Korb-Modular/01_PUSHER/04_Docs/BOM_Pusher_08112016_ver03.xls

Pusher_08112016_ver03.brd
Qty | Value | Device | Package | Parts | Description | MOUSER
Resistors
7 | 51 | R-EU_R0603 | R0603 | R56, R57, R58, R59, R60, R61, R63 | RESISTOR, European symbol | 667-ERJ-3GEYJ510V
5 | 270 | R-EU_R0603 | R0603 | R27, R34, R37, R39, R55 | RESISTOR, European symbol | 667-ERJ-3EKF2700V
4 | 1k | R-EU_R0603 | R0603 | R8, R14, R17, R24 | RESISTOR, European symbol | 667-ERJ-3EKF1001V
1 | 2K | R-EU_R0603 | R0603 | R54 | RESISTOR, European symbol | 667-ERJ-3EKF2001V
1 | 3,3K | R-EU_R0603 | R0603 | R52 | RESISTOR, European symbol | 667-ERJ-3EKF3301V
5 | 10k | R-EU_R0603 | R0603 | R48, R49, R50, R51,R53 | RESISTOR, European symbol | 667-ERJ-3EKF1002V
25 | 100k | R-EU_R0603 | R0603 | R1, R3, R4, R5, R6, R7, R9, R11, R13, R15, R16, R18, R19, R21, R23, R25, R26, R28, R29, R31, R33, R35, R36, R38 | RESISTOR, European symbol | 667-ERJ-3EKF1003V
7 | 470k | R-EU_R0603 | R0603 | R2, R10, R12, R20, R22, R30, R32 | RESISTOR, European symbol | 667-ERJ-3EKF4703V
8 | 10kb | POT | ALPS_POT | R40, R41, R42, R43, R44, R45, R46, R47 |  | 688-RK09L1140A66 REMARK: please check your front panels first or be ready to drill their holes bigger The diameter of he mouser pot is bigger then the panel holes
4 | FSR |  |  | X1, X2, X3, X4 | Force Sensitive Resistor 0.5" | Sparkfun: https://www.sparkfun.com/products/9375
Capacitors
8 | 100n | C-USC0603 | C0603 | C1, C2, C3, C12, C13, C14, C15, C17 | CAPACITOR, American symbol | 81-GRM188R71E104JA1J
6 | 1u | C-USC0603 | C0603 | C4, C5, C6, C7, C8, C9 | CAPACITOR, American symbol | 81-GRM18R61A105KA61J
2 | 10u | CPOL-USA | PANASONIC_A | C10, C11 | POLARIZED CAPACITOR, American symbol | 647-UWX1C100MCL2
2 | 22u | CPOL-USC | PANASONIC_C | C16, C19 | POLARIZED CAPACITOR, American symbol | 667-EEE-FP1E220AR
2 | 1N5819HW | DIODE-SOD123 | SOD123 | D1, D2 | DIODE | 621-1N5819HW-F
Semiconductors
1 | 2N3904 | MMBT3904LT1-NPN-SOT23-BEC | SOT23-BEC | T1 | NPN Transistror | 512-MMBT3904
1 | 4051D | 4051D | SO16 | IC9 | 8-channel ANALOG MULTIPLEXER | 771-HEF4051BTD-T
1 | 74HC595D | 74HC595D | SO16 | IC5 | 8-bit SHIFT REGISTER, output latch | 595-CD74HC595M
1 | 7806T | 7806T | TO220H | IC10 | Positive VOLTAGE REGULATOR | 755-BA17806T
1 | LM1117-5.0 | REG1117 | SOT223 | IC11 | 800mA and 1A Low Dropout (LDO) Positive Regulator | 926-LM1117MPX5.0NOPB
3 | MCP4822-E/SN | MCP4822-E/SN | SO08 | IC6, IC7, IC8 | Microchip MCP4822 | 579-MCP4822-E/SN
1 | TL072D | TL072D | SO08 | IC4 | OP AMP | 511-TL072CDT
3 | TL074D | TL074D | SO14 | IC1, IC2, IC3 | OP AMP | 511-TL074IYDT
Misc
2 | PTCSMD | PTCSMD | PTC-1206 | P1, P2 | Resettable Fuse PTC | 504-PTS120616V025
5 |  | LED3MM | LED3MM | LED1, LED2, LED3, LED4, LED5 | LED | 604-WP424GDT
1 | PCB ver03.brd |  |  |  |  | www.Korb-Modular.com
1 | Panel |  |  |  |  | www.Korb-Modular.com
Mechanical
1 | M05X2PTH | M05X2PTH | AVR_ICSP | JP2 | Header 5x2 | 5X2 Power Connector
2 | Arduino Socket |  |  |  | Header 15x1 | 855-M20-7821546
12 | Jack | WQP-PJ301M-12_JACK | WQP-PJ301M-12_JACK | J1, J2,J3,J4,J5,J6,J7,J8,J9,J10,J11,J12 |  | e.g Thonk
Controller
1 | NANO | NANO | NANO | U$1 | Arduino Nano
