Korb-Modular/01_PUSHER/04_Docs/Pusher Build Guide.pdf

## KORB

## Pusher Build Guide

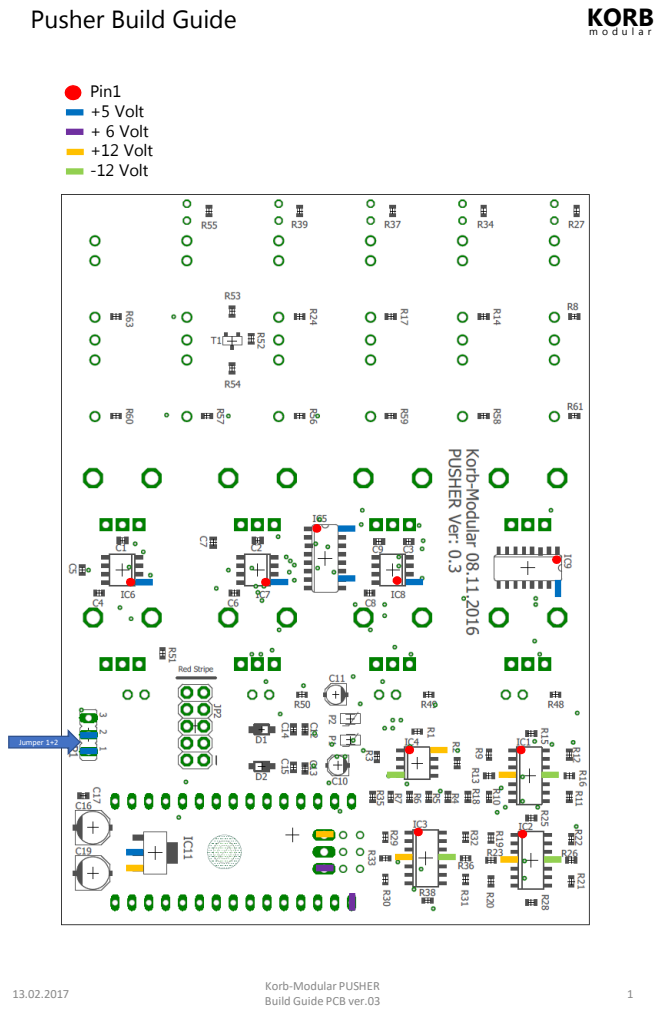
[picture p1: page 1]
Pin1; +5 Volt; + 6 Volt; +12 Volt; -12 Volt; Jumper 1+2; Korb-Modular PUSHER; Build Guide PCB ver.03
