Korb-Modular/01_PUSHER/01_Panel/Pusher_12122016_ver03.pdf

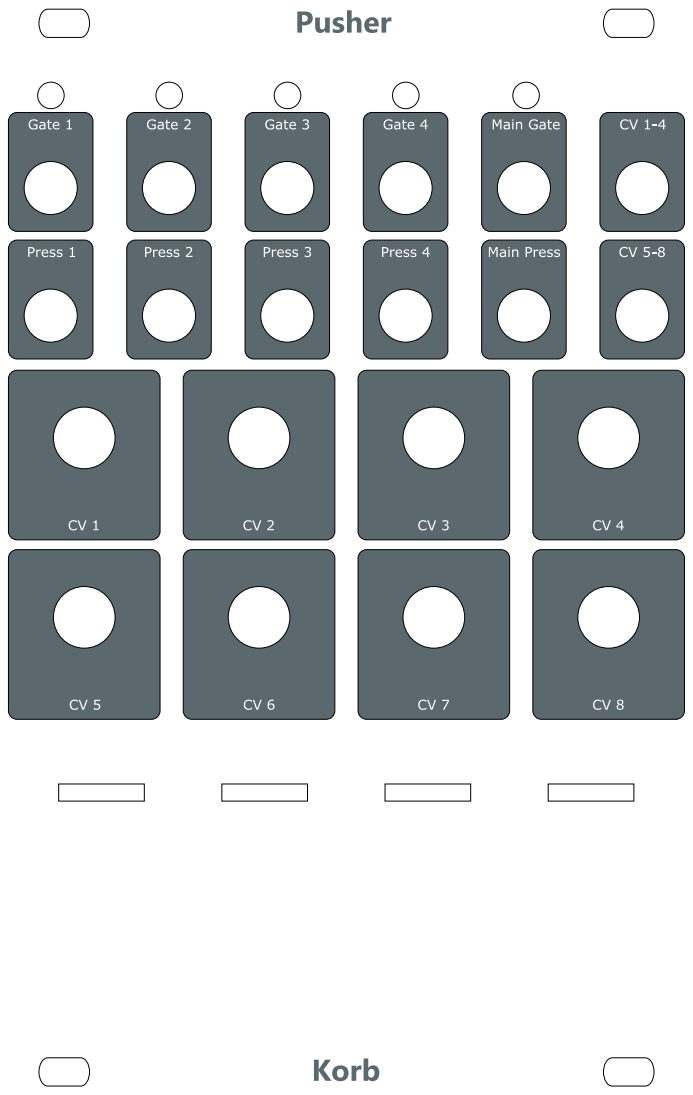
[picture p2: page 1]
