Korb-Modular/01_PUSHER/02_PCB/Pusher_PCB_Bottom_08112016_ver03.pdf

# R4 R⁴⁸ R⁴⁹ R5 R⁵⁰

# R60 R⁶¹

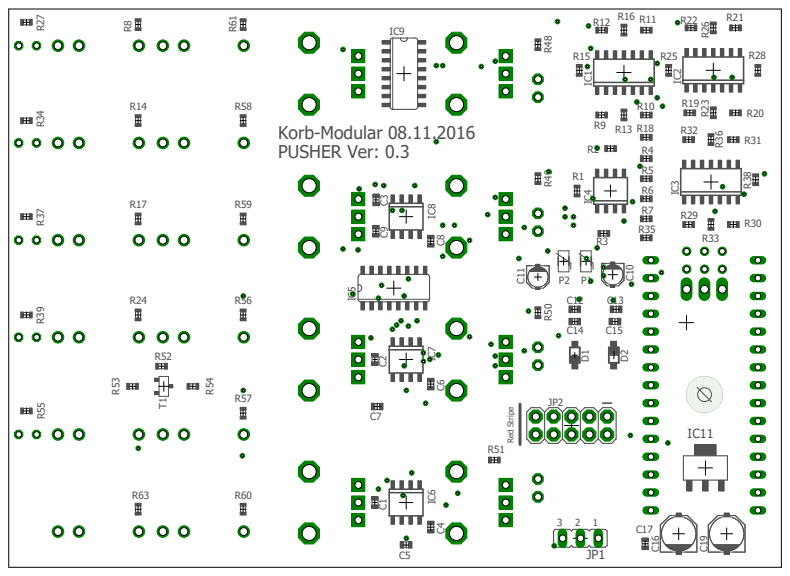
[picture p3: page 1]
