Korb-Modular/01_PUSHER/02_PCB/Pusher_PCB_Top_08112016_ver03.pdf.pdf

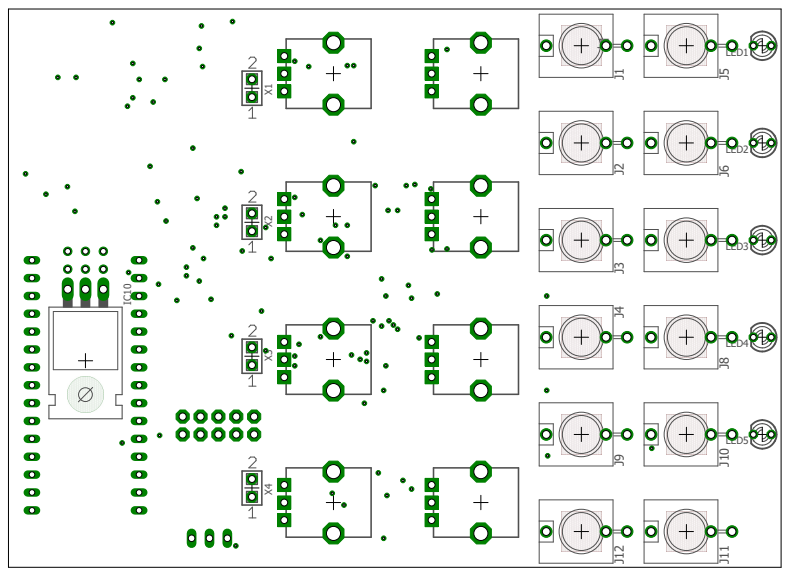
[picture p4: page 1]
