Korb-Modular/01_PUSHER/(commit log)

2017-02-11 New Value R2, R52, R53, R54
    [BOM_Pusher_08112016_ver03.xls]
2017-02-14 Drillsize info added
    [BOM_Pusher_08112016_ver03.xls]
2017-03-07 FSR description added
    [BOM_Pusher_08112016_ver03.xls]
2017-03-07 Revert "FSR description added"
    This reverts commit dc2c08382e9853cb514d0da17b1e09a90af8576e.
    [BOM_Pusher_08112016_ver03.xls]
2017-03-07 FSR Despription added
    [BOM_Pusher_08112016_ver03.xls]
2017-03-10 EEprom fix
    Default values in case of empty Epprom
    [Pusher.ino]
2017-03-22 arduino sockets added
    [BOM_Pusher_08112016_ver03.xls]
2017-03-22 change quantity of 407k from 6 to 7
    [BOM_Pusher_08112016_ver03.xls]
2017-04-20 Update Partnumber C16, C19
    [BOM_Pusher_08112016_ver03.xls]
